jjg/universal-stompbox/images/A-B-Switch-Dual-LED.png

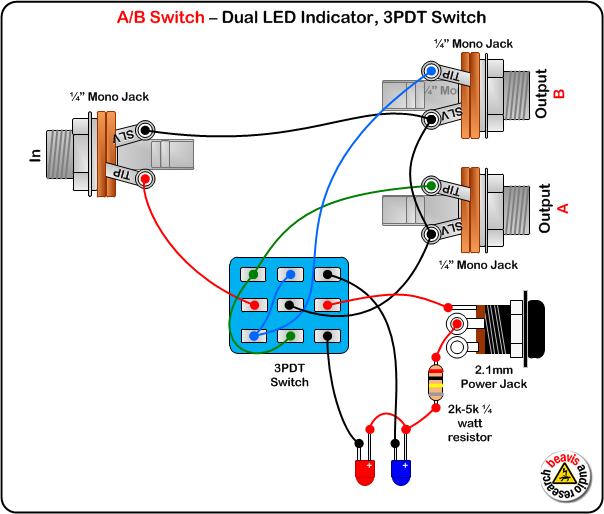
images/A-B-Switch-Dual-LED.png
