jjg/universal-stompbox/stls/usb_v4_complete.stl

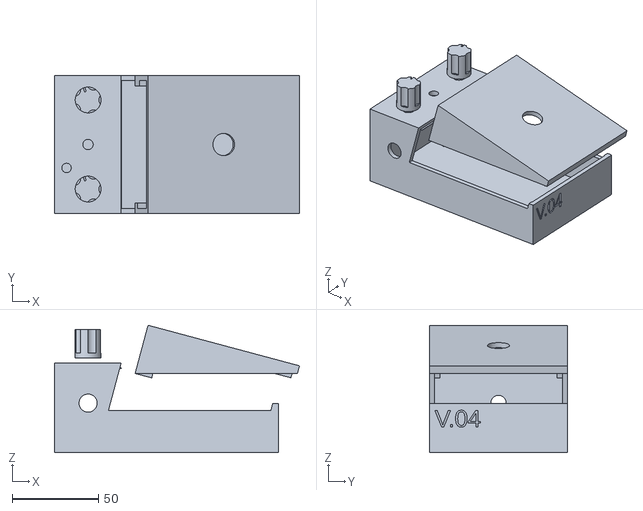
[picture p5: CAD file, 2024-01-04]
stls/usb_v4_complete.stl
142.2 x 80.0 x 74.0
