jjg/universal-stompbox/stls/usb_knob_v5.stl

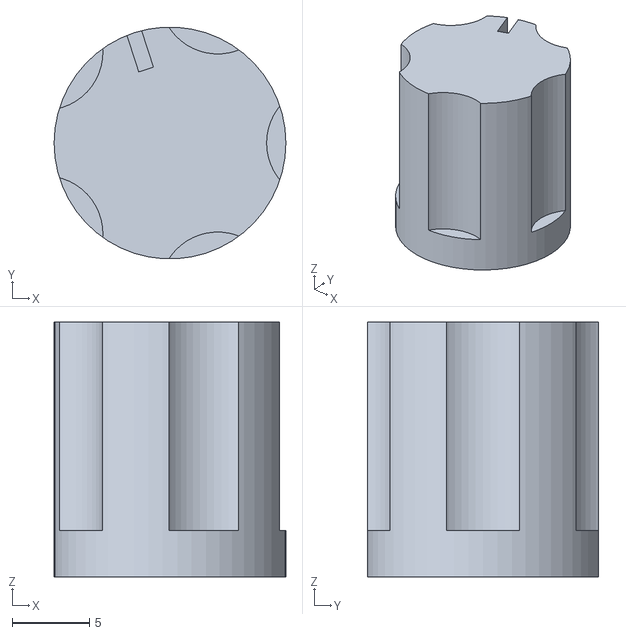
[picture p6: CAD file, 2024-01-28]
stls/usb_knob_v5.stl
15.0 x 15.0 x 16.5
