jjg/universal-stompbox/stls/usb_base_v4.stl

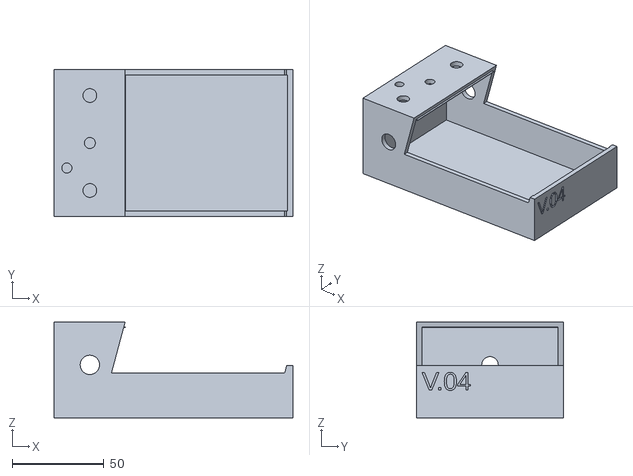
[picture p7: CAD file, 2024-01-04]
stls/usb_base_v4.stl
130.0 x 80.0 x 52.0
