jjg/universal-stompbox/stls/usb_base_cover_v2.stl

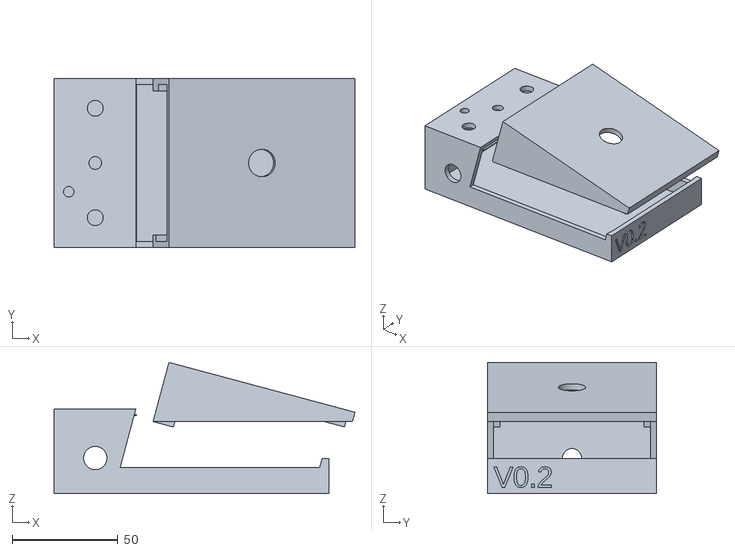
[picture p8: CAD file, 2024-01-04]
stls/usb_base_cover_v2.stl
142.2 x 80.0 x 62.0
