jjg/universal-stompbox/stls/usb_cover_v4.stl

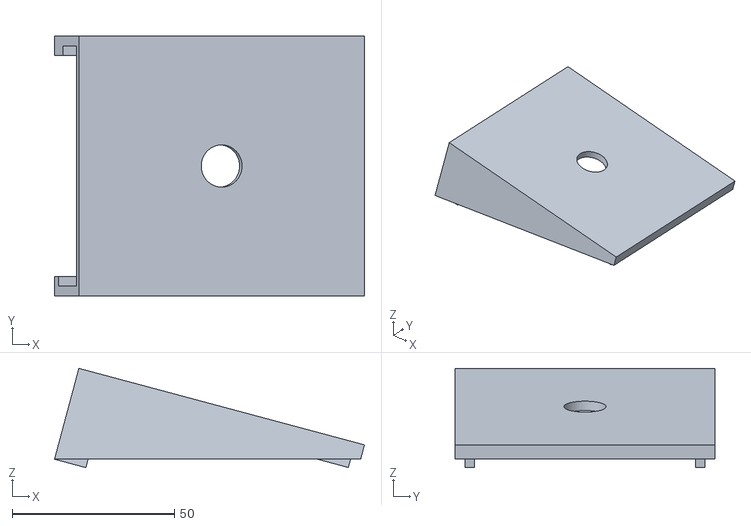
[picture p9: CAD file, 2024-01-04]
stls/usb_cover_v4.stl
95.4 x 80.0 x 30.6
