jjg/universal-stompbox/(list of files, cad)

Other CAD files:
stls/usb_knob_v4.stl
stls/usb_base_v3.stl
