jjg/universal-stompbox/(commit log)

2023-12-24 Initial commit.
    [overview.scad]
2023-12-24 Additional parts, holes
    [overview.scad]
2023-12-25 phone jacks should be on the side not the top.
    [overview.scad]
2023-12-25 freeze before refactor
    [overview.scad]
2023-12-25 Hole tweaking, fixing other bugs.
    [overview.scad]
2023-12-26 reduce overall height
    [overview.scad]
2023-12-26 connect base and control panel into single part.
    [overview.scad]
2023-12-26 Angled cover and other enhancements.
    [overview.scad]
2023-12-29 Deepen base to make room for big pushbutton.
    [overview.scad]
2023-12-29 Fix error in bottom of base cut-out.
    [overview.scad]
2024-01-03 place knobs and update version
    [overview.scad]
2024-01-04 Add tolerance to knob.
    [overview.scad]
2024-01-28 Externalize knob module.
    [overview.scad, usb_knob_v4.stl, usb_knob_v5.stl]
